richieaneks/Development-of-an-Artificial-Neural-Network-ANN-Based-Speed-Control-for-Autonomous-Vehicles/control_surface.png

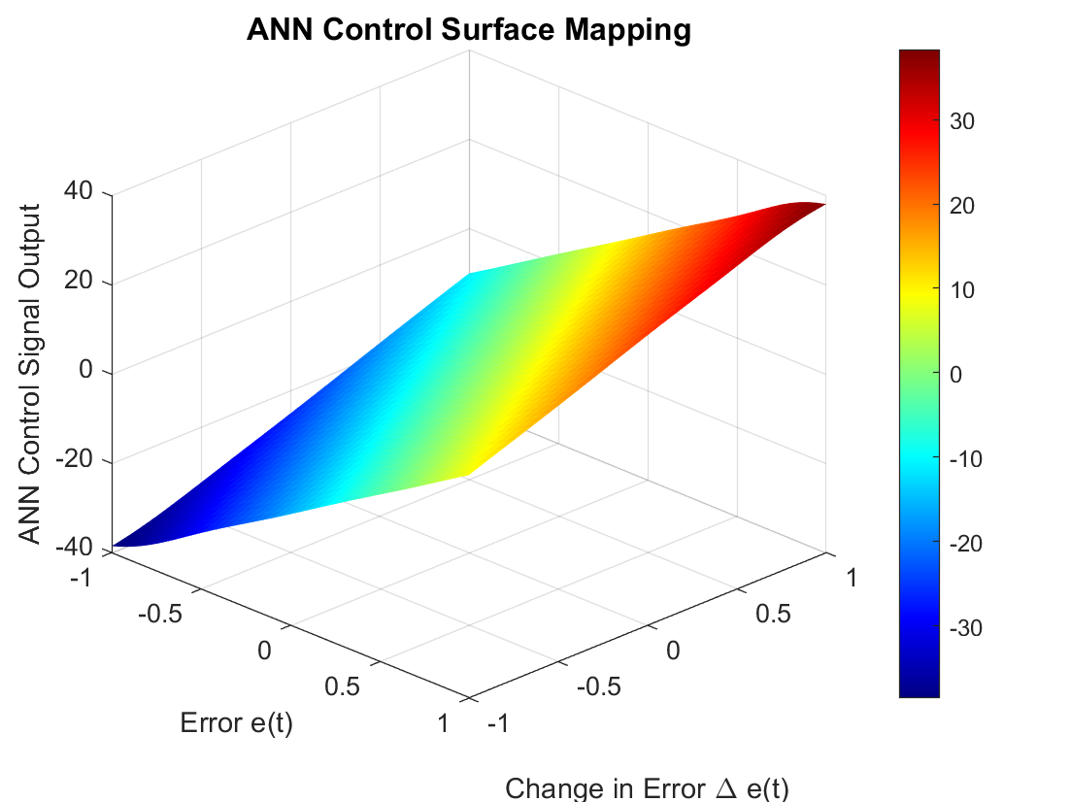
control_surface.png
