richieaneks/Development-of-an-Artificial-Neural-Network-ANN-Based-Speed-Control-for-Autonomous-Vehicles/controller_effort.png

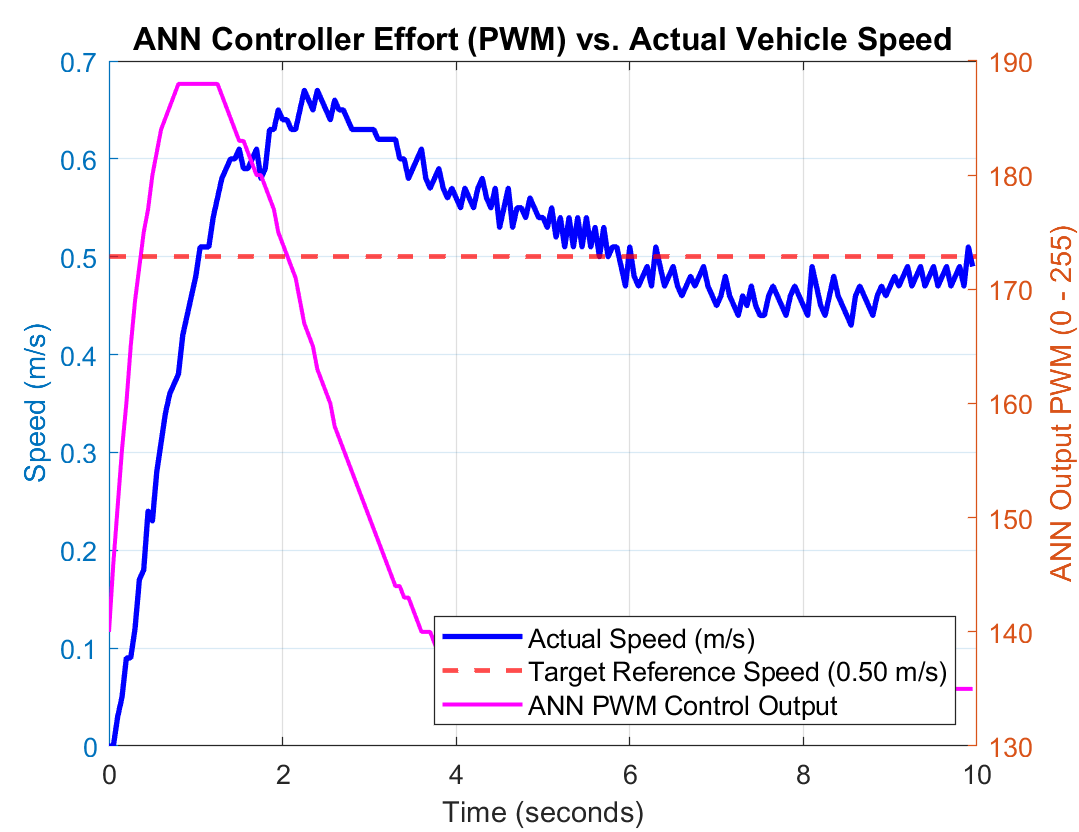
controller_effort.png
