richieaneks/Development-of-an-Artificial-Neural-Network-ANN-Based-Speed-Control-for-Autonomous-Vehicles/error_distribution.png

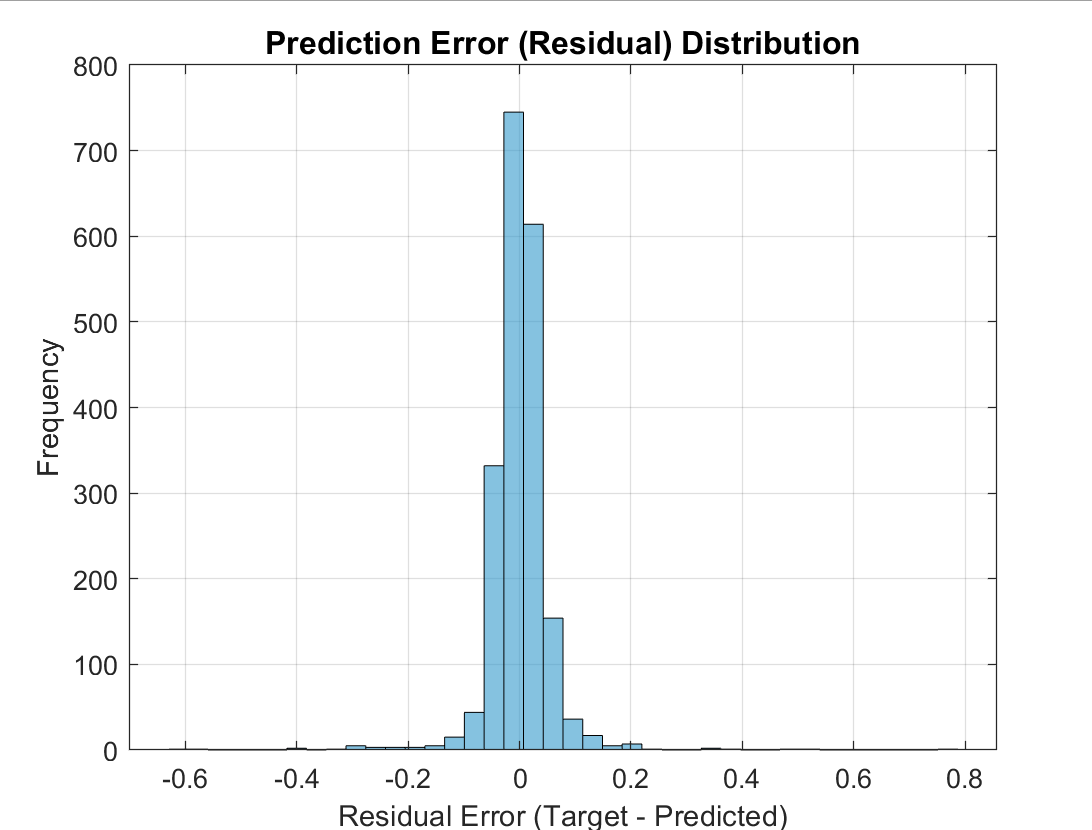
error_distribution.png
