richieaneks/Development-of-an-Artificial-Neural-Network-ANN-Based-Speed-Control-for-Autonomous-Vehicles/integral_errors.png

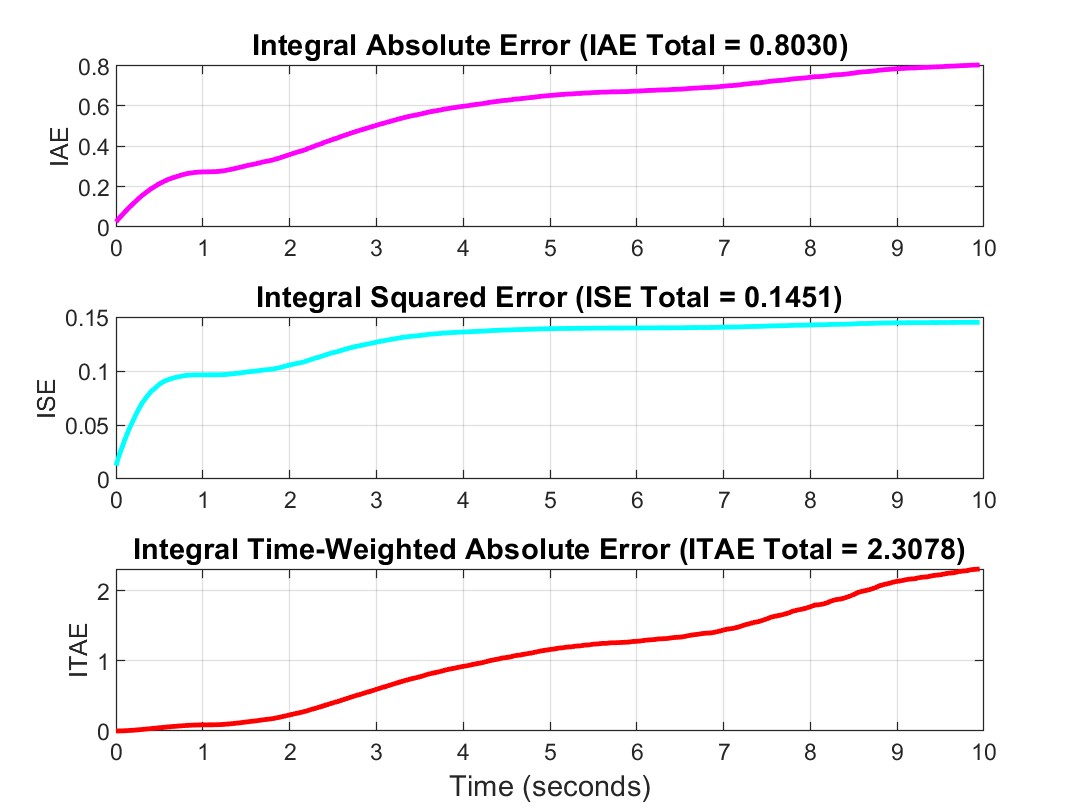
integral_errors.png
