richieaneks/Development-of-an-Artificial-Neural-Network-ANN-Based-Speed-Control-for-Autonomous-Vehicles/Objective 1/linear_regression.png

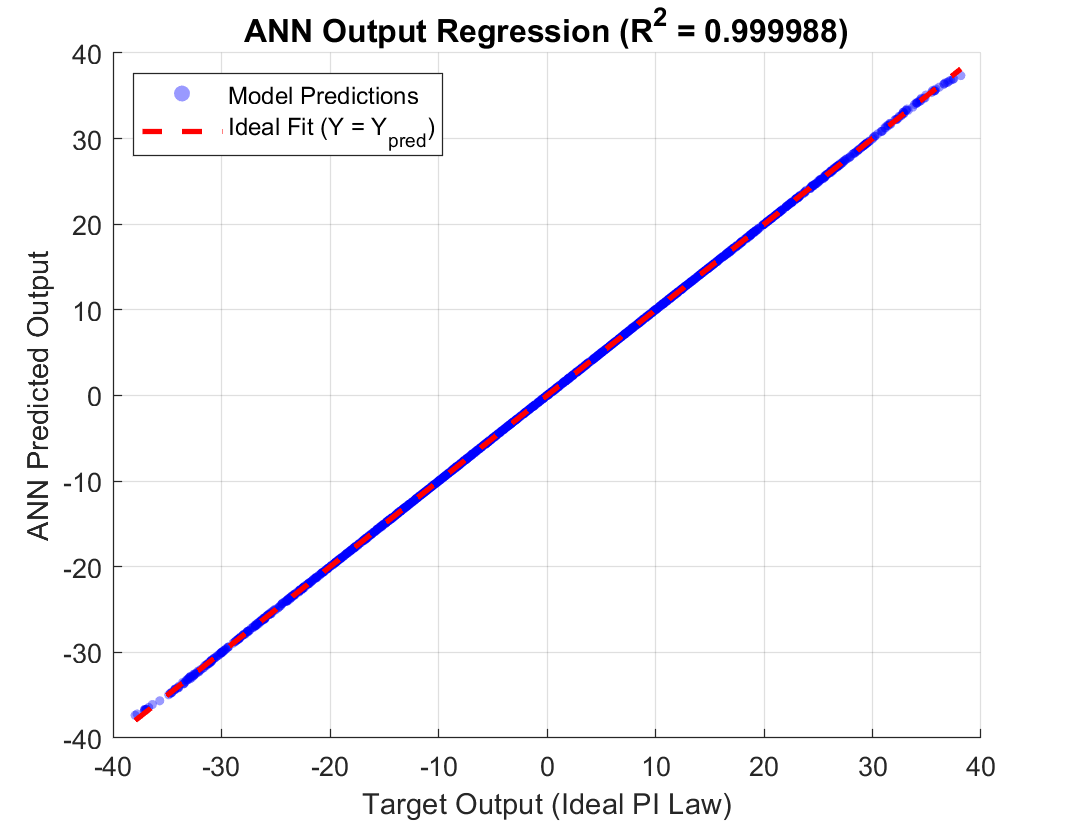
Objective 1/linear_regression.png
