richieaneks/Development-of-an-Artificial-Neural-Network-ANN-Based-Speed-Control-for-Autonomous-Vehicles/Objective 1/loss_convergence.png

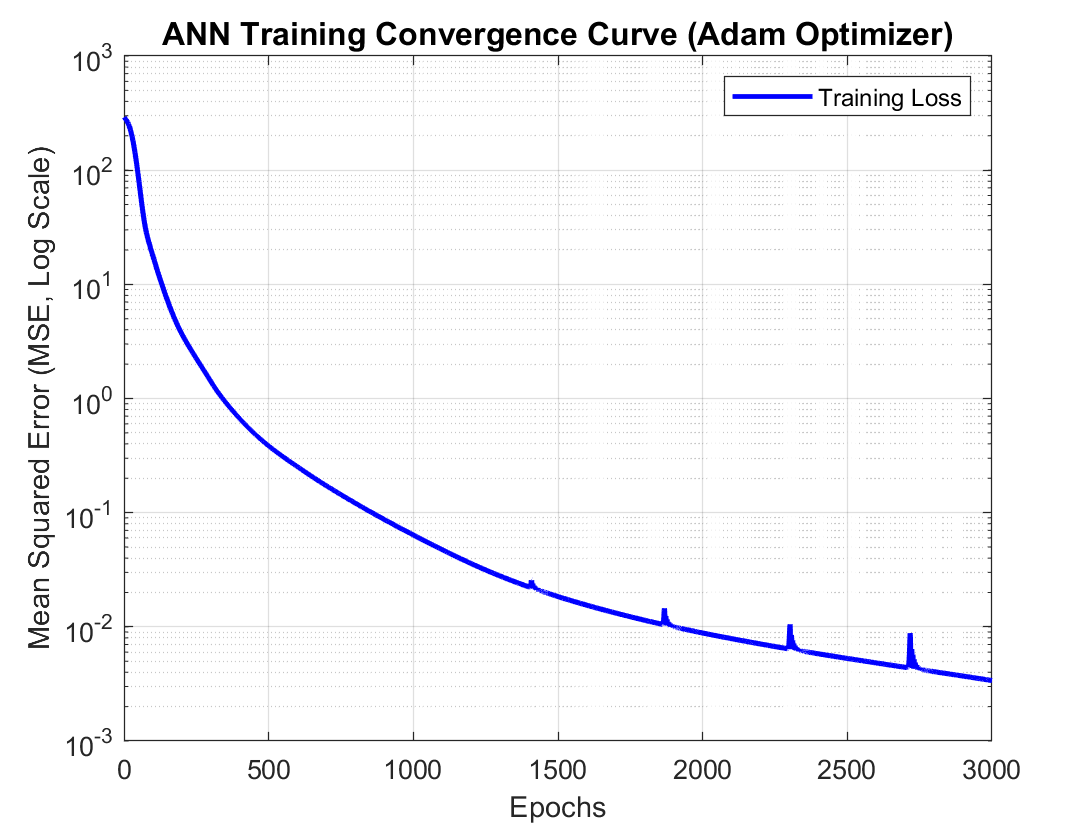
Objective 1/loss_convergence.png
