richieaneks/Development-of-an-Artificial-Neural-Network-ANN-Based-Speed-Control-for-Autonomous-Vehicles/Operating Manual.docx

This Operating Manual provides the standard operating procedures, hardware pinout mappings, power calibration steps, and firmware upload protocols for the Artificial Neural Network (ANN) Speed Control System on the 4WD Autonomous Testbed.

1. Hardware Inventory & System Specifications

Component | Specifications / Parameters | Functional Purpose
Microcontroller | ESP32 Development Board (38-Pin Type-C) | Real-time neural network inference engine and sensor processing.
Motor Driver | L298N Dual H-Bridge Module (2A peak/bridge, 5V–35V) | Drives 4 DC motors in a dual-channel skid-steer configuration.
Chassis & Actuators | 4WD Acrylic Chassis with 4 DC TT Gear Motors | Physical vehicle platform and actuation system.
Primary Power | 2x 18650 Li-ion Batteries (7.4V – 8.4V nominal) | Main power supply for motors and processing logic.
Battery Management | 2S 20A Balanced Lithium Protection Board | Protects battery cells from overcharge, over-discharge, and short circuits.
Voltage Regulator | XL4015E 5A DC-DC Buck Converter | Steps down battery voltage to a regulated 5.0V for the ESP32.
Speed Sensor | LM393 Optical Slot Sensor + 20-slot Encoder Wheel | Measures wheel rotational speed for closed-loop feedback.
Power Control | KCD11 Small Power Rocker Switch | Master power disconnect for the system.

2. Power Distribution & Safety Calibration

Battery Holder Modification & BMS Wiring

Because standard 2-slot battery holders only provide two output wires, you must modify the holder to supply a middle balance line for the 2S BMS:

1. Modify Battery Holder: Solder a wire to the continuous metal bridge terminal at the back of the empty battery holder (connecting Battery 1 to Battery 2) to form the Middle Balance wire ( BM ).
2. Wire to BMS ( B -Pads):
  - B+ Pad: Red wire from main positive terminal.
  - B- Pad: Black wire from main negative terminal.
  - BM / B1 Pad: Custom middle balance wire.
3. Master Output Wiring ( P -Pads):
  - P+ Pad: Master Positive Output. Route this through the KCD11 Rocker Switch before splitting to the L298N 12V terminal and XL4015 IN+ terminal.
  - P- Pad: Master Ground Line. Route to the L298N GND terminal and XL4015 IN- terminal.

Critical Overvoltage Risk

Do NOT connect the XL4015 Buck Converter output to the ESP32 without checking its output voltage first! Out-of-the-box step-down modules can output voltages high enough to instantly destroy the microcontroller.

Buck Converter Voltage Calibration Procedure

1. Disconnect the XL4015 OUT+ wire from the ESP32.
2. Turn on the battery power using the KCD11 Rocker Switch.
3. Measure the DC voltage across the OUT+ and OUT- terminals of the XL4015 using a digital multimeter.
4. Using a small flathead screwdriver, adjust the blue potentiometer screw until the output measures 5.0V to 5.21V.
5. Turn off power, then wire OUT+ safely to the VIN / 5V pin on the ESP32 and OUT- to an ESP32 GND pin.

3. Hardware Pinout & Signal Connections

Motor Driver Wiring (4-to-2 Skid-Steer Configuration)

Parallel-wire the DC gearmotors on each side of the chassis to run as a single channel:

Left Side Motors: Combine red wires to L298N OUT1; black wires to L298N OUT2.

- Right Side Motors: Combine red wires to L298N OUT4; black wires to L298N OUT3.

Remove Enable Jumpers

You MUST remove the two black plastic jumper caps on the ENA and ENB pins of the L298N driver. Leaving them attached forces the motors to run only at 100% duty cycle, overriding all dynamic PWM speed commands from the ESP32.

ESP32 Control Interface Pin Mapping

Peripheral | Board Pin | ESP32 GPIO | Description / Notes
L298N Driver | ENA | GPIO 14 | Left Motor Speed Control (PWM Output)
| IN1 | GPIO 27 | Left Motor Direction Forward
| IN2 | GPIO 26 | Left Motor Direction Reverse
| IN3 | GPIO 25 | Right Motor Direction Forward
| IN4 | GPIO 33 | Right Motor Direction Reverse
| ENB | GPIO 32 | Right Motor Speed Control (PWM Output)
LM393 Encoder | VCC | 3V3 Pin | Do NOT use 5V (keeps output signal within 3.3V logic)
| GND | GND Pin | Common system ground connection
| D0 | GPIO 18 | Optical Pulse Interrupt Signal

4. Software Configuration & Firmware Protocol

USB-to-UART Driver Installation

If the ESP32 displays a yellow exclamation mark (CP2102 USB to UART Bridge Controller) under Windows Device Manager:

1. Download the official Silicon Labs CP210x Universal Windows Driver.
2. Extract the .zip archive, right-click silabser.inf, and select Install.
3. Re-open Arduino IDE and select the updated COM port under Tools > Port.

Firmware Architecture Specifications

- Loop Execution Frequency: 20 Hz (Fixed 50 ms discrete control interval).
- Signal Conditioning: Raw encoder pulses are passed through a First-Order Low-Pass Infinite Impulse Response (IIR) filter:

V_(filtered) =0.75⋅V_(prev) +0.25⋅V_(raw)

- Inference Engine: The embedded C++ firmware propagates error ( e ) and change in error ( Δe ) inputs through hardcoded neural network weights to generate PWM commands.
- Telemetry System: Logs 200 data points (10 seconds of runtime) directly to ESP32 SPIFFS flash memory for untethered extraction.

5. Testing, Calibration & Operational Workflows

1. Run Hardware Saturation Test: Phase 1 Verification.

Upload the max speed calibration sketch to verify raw motor capacity. Disconnect the USB cable, place the chassis on the ground, and run for 5 seconds. Verify the measured ceiling velocity via Serial Monitor (typically ~1.2 m/s on floor surface, up to ~1.9 m/s under no-load condition).

2. Execute Untethered Operational Run: Phase 2 Deployment.

Flash the main control firmware to the ESP32. Set target reference speed between 0.20 m/s and 0.70 m/s (default 0.50 m/s). Unplug the USB cable, place the car on an open floor, and turn on the battery switch. The status LED will blink 3 times, operate under closed-loop ANN control for 10 seconds, and stop automatically.

3. Extract Telemetry Data: Phase 3 Verification.

Turn off the power switch, reconnect the ESP32 to the PC via USB, open the Arduino Serial Monitor at 115200 baud, and type READ. The onboard telemetry will dump the captured performance metrics ( e , Δe , PWM) for evaluation.
